JackDesBwa/Genfreq/board/schematics.pdf

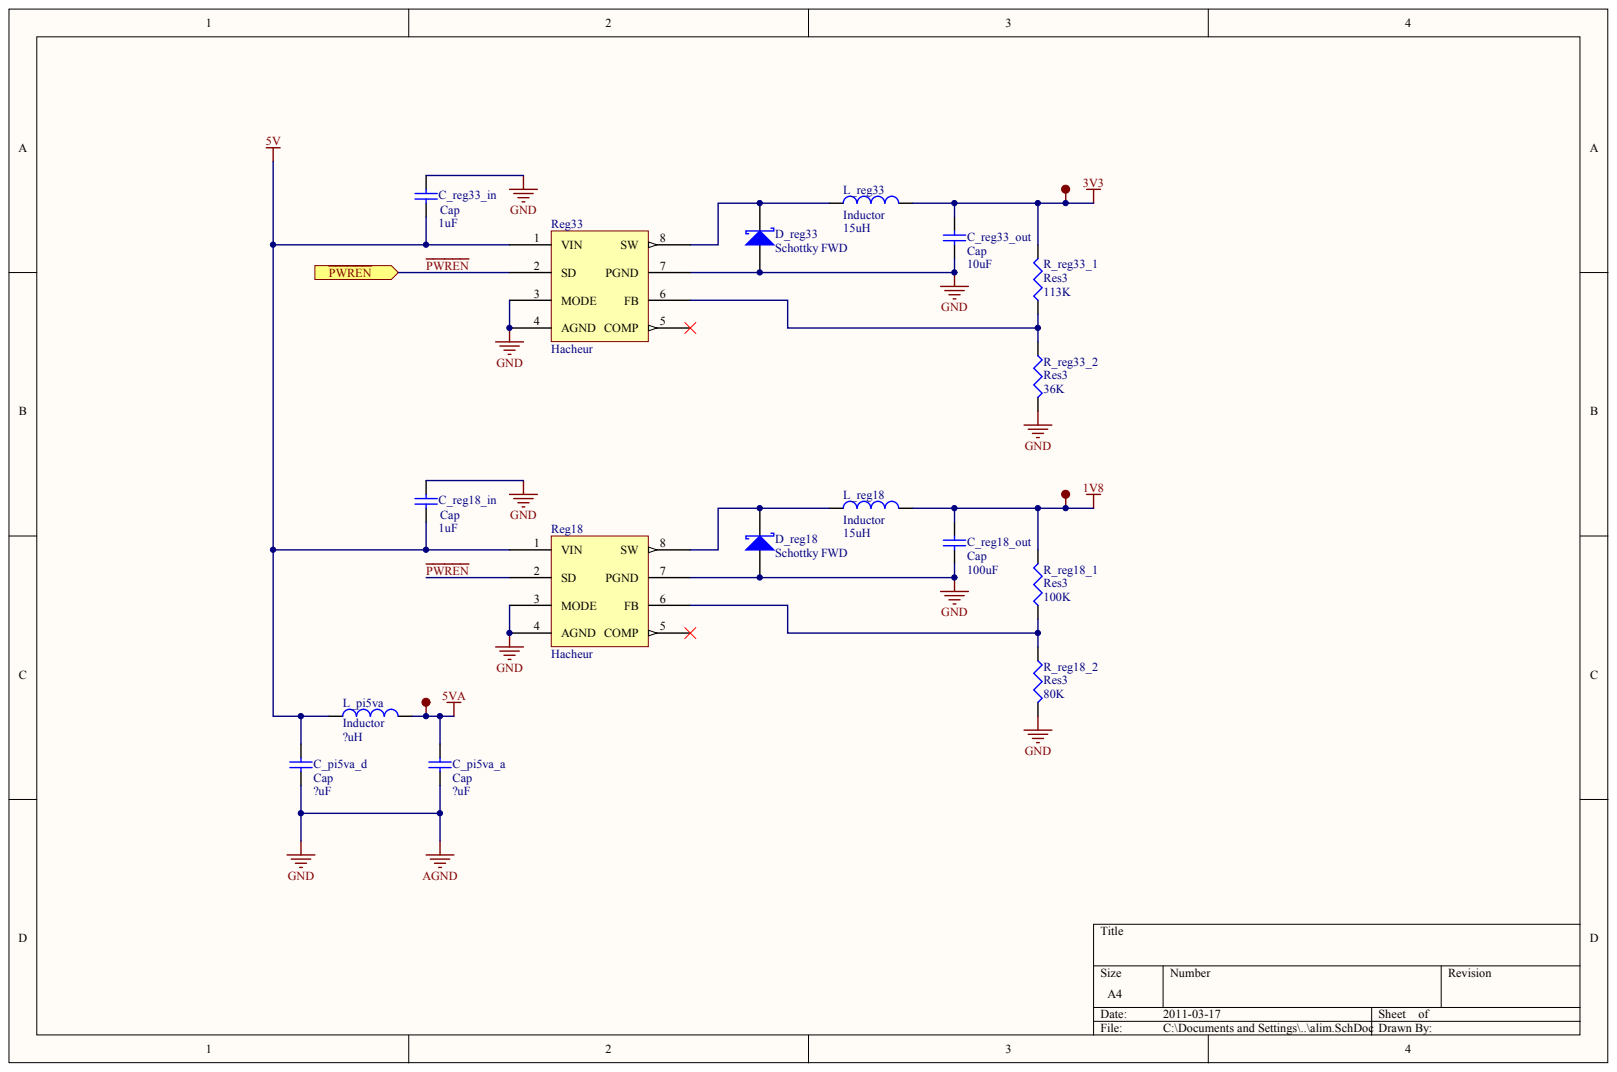
[picture p1: page 1]

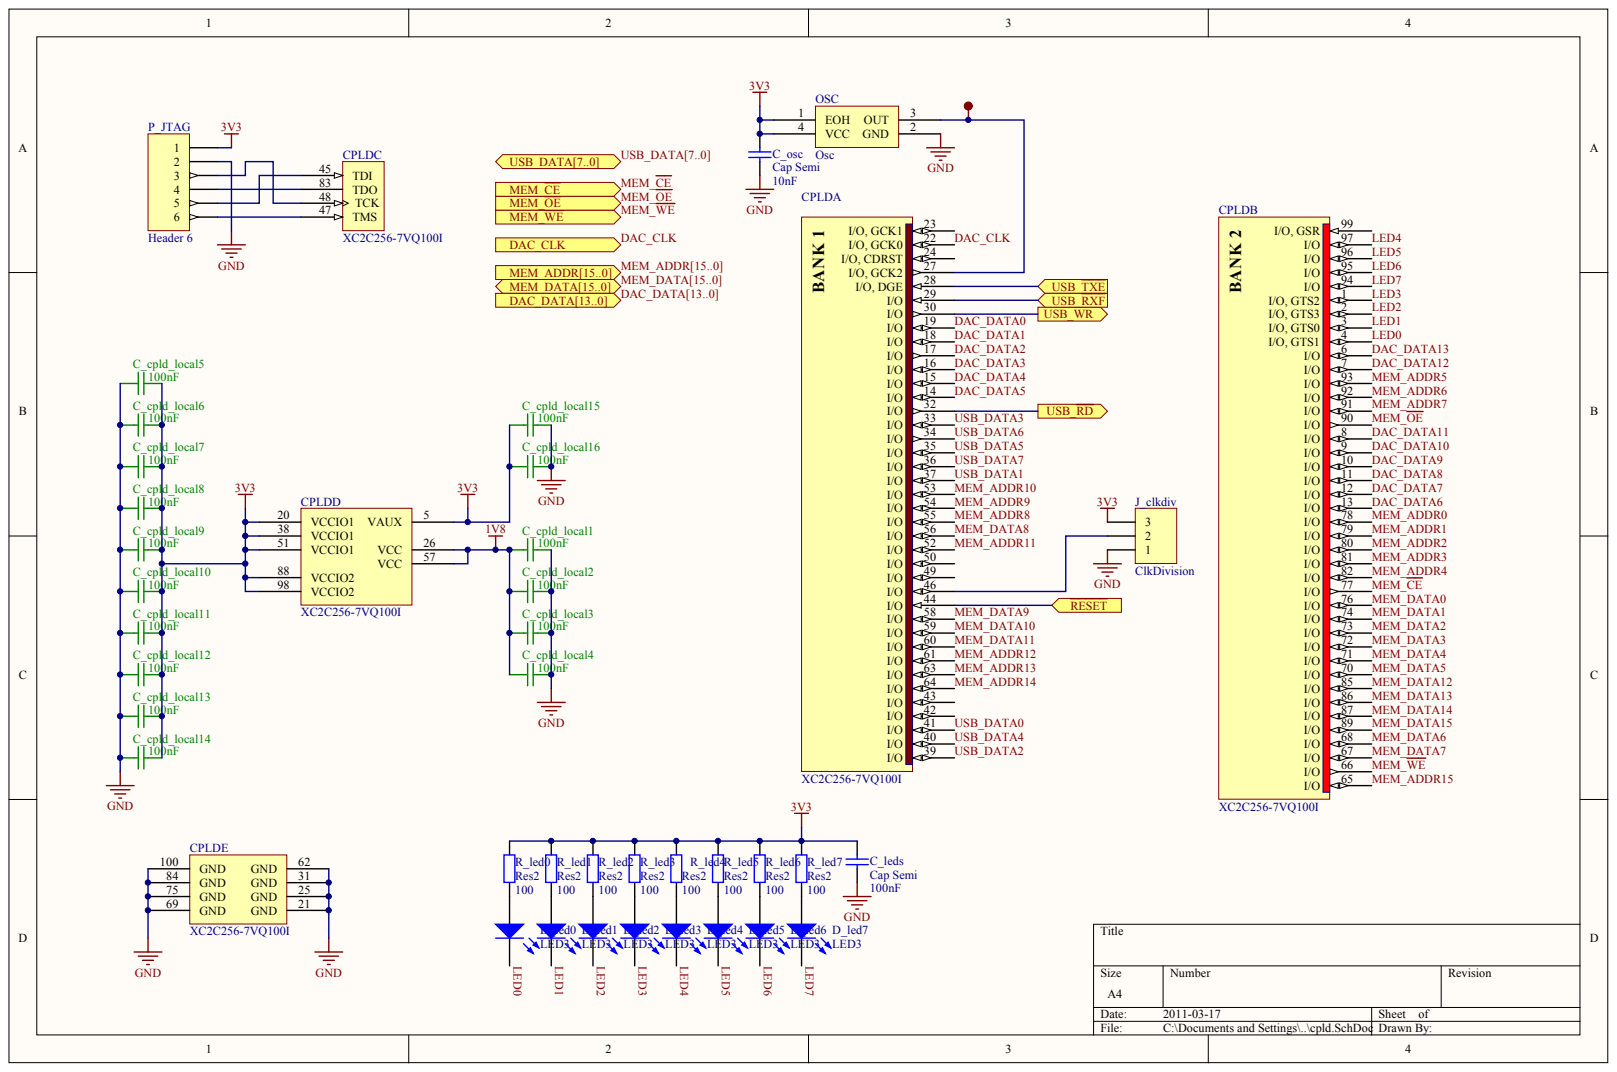
[picture p2: page 2]

TDO 83
TCK 48
TMS 47

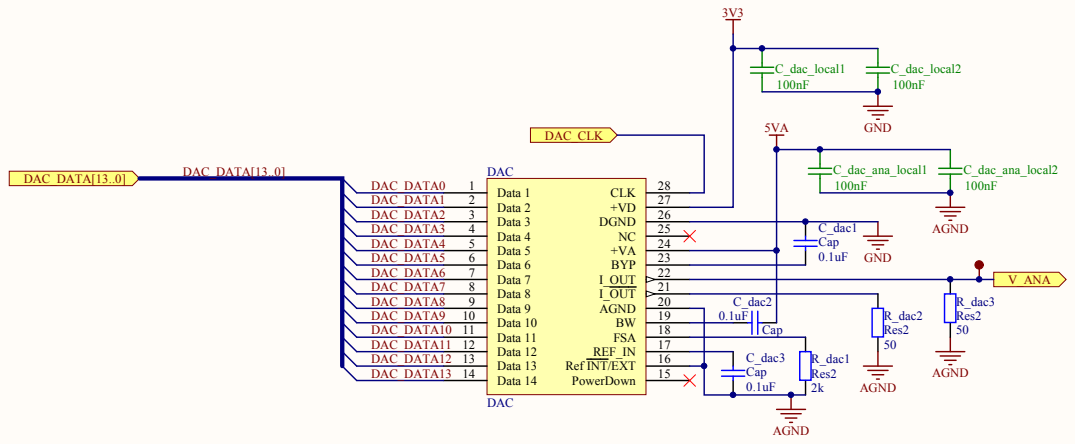
[picture p3: page 3]

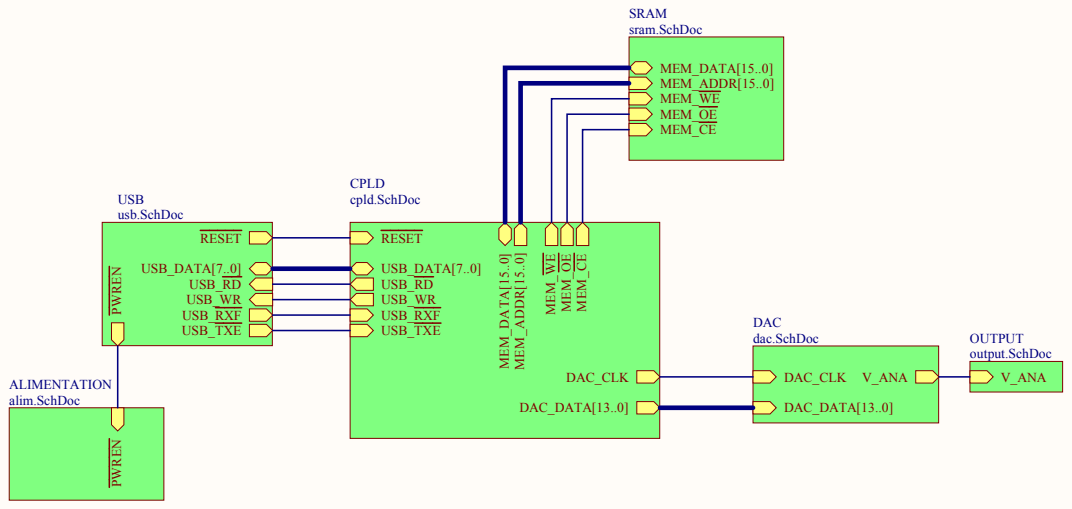
[picture p4: page 4]

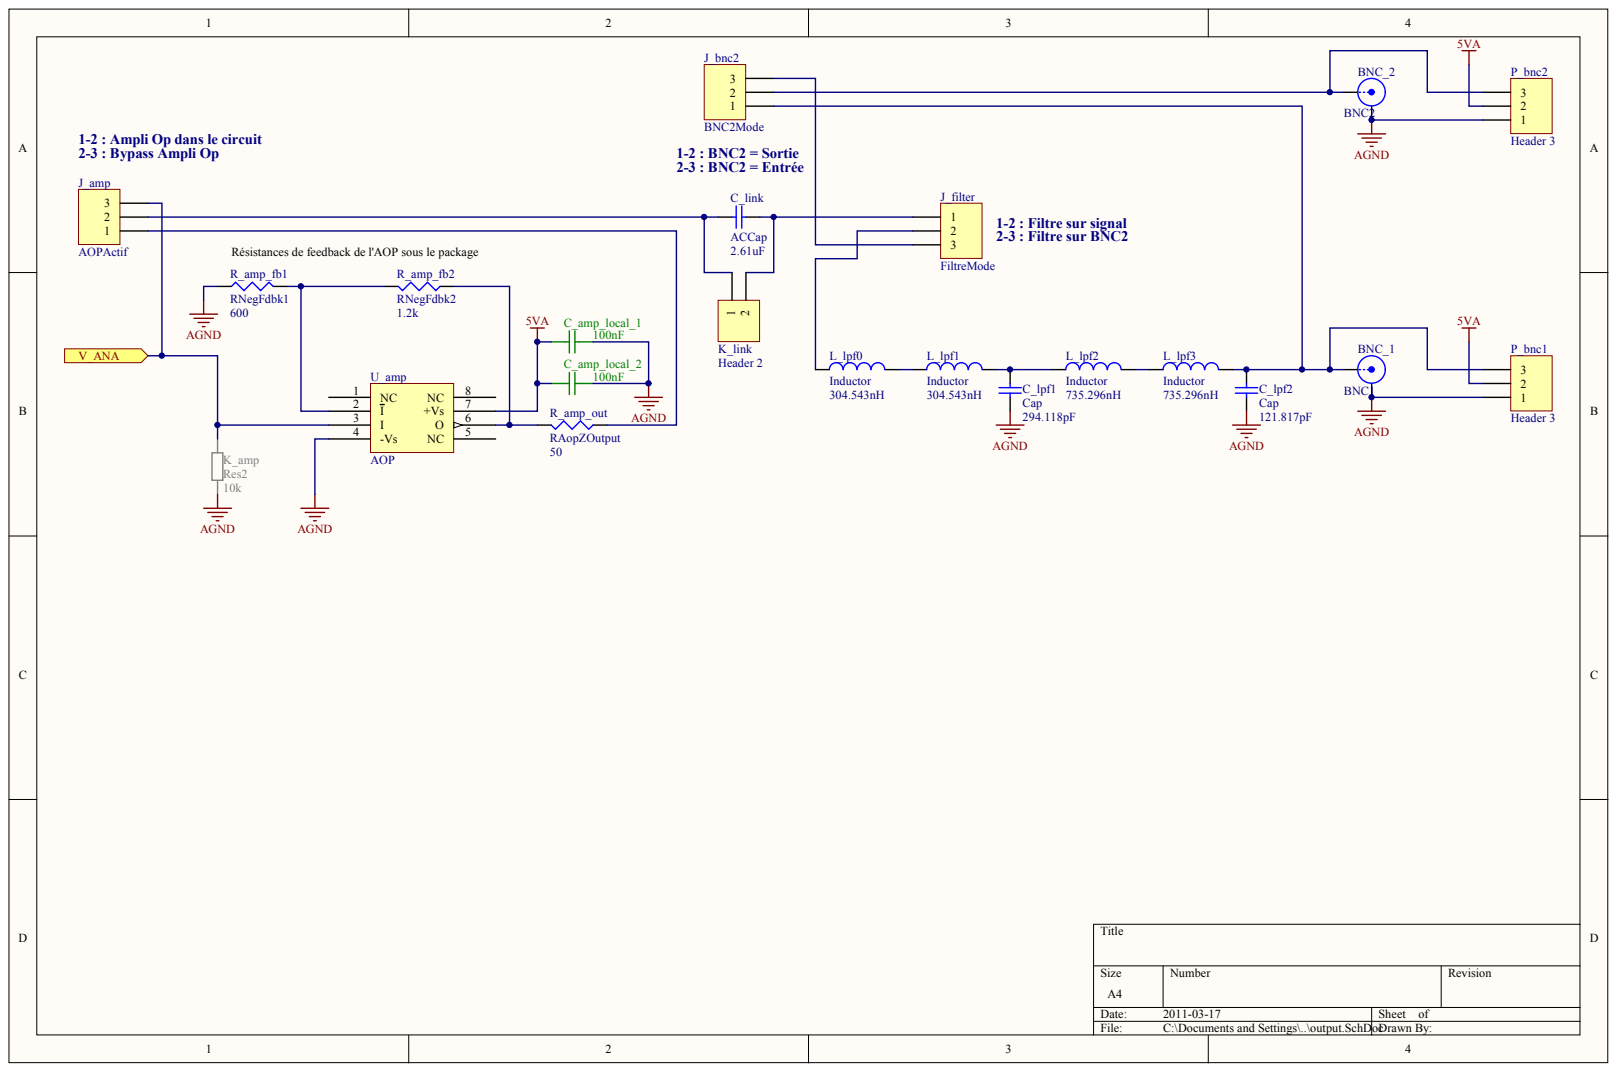
[picture p5: page 5]

1-2 : Ampli Op dans le circuit

Résistances de feedback de l'AOP sous le package

L_lpf0

BNC_1

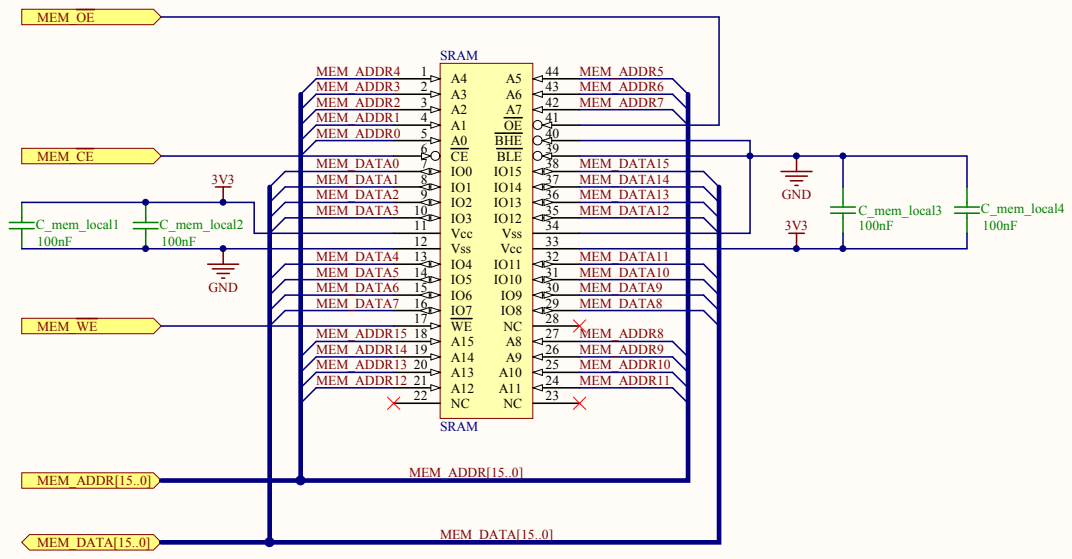
[picture p6: page 6]

MEM_ADDR2 MEM_ADDR1 | BLE A2 3 A1 4 | 39 BHE 40 OE 41 A7 42 A6 43 A5 44 A4 1 MEM_ADDR7

MEM_ADDR0 | A0 5 CE 6 IO12

3V3 | MEM_DATA0 MEM_DATA1 | IO0 7 IO1 8 | 35 IO13 36 IO14 37 IO15 38 | MEM_DATA15 MEM_DATA14

MEM_DATA2 | IO2 9 Vcc IO8 NC A11 | 33 Vss 34 | MEM_DATA13 MEM_DATA12

C_mem_local2 | | MEM_DATA3 | | IO3 10 Vcc 11

100nF | | 100nF | | | Vss 12

GND | | MEM_DATA4 MEM_DATA5 MEM_DATA6 | IO4 13 IO5 14 IO6 15 IO7 16 WE 17 | 29 IO9 30 IO10 31 IO11 32 28

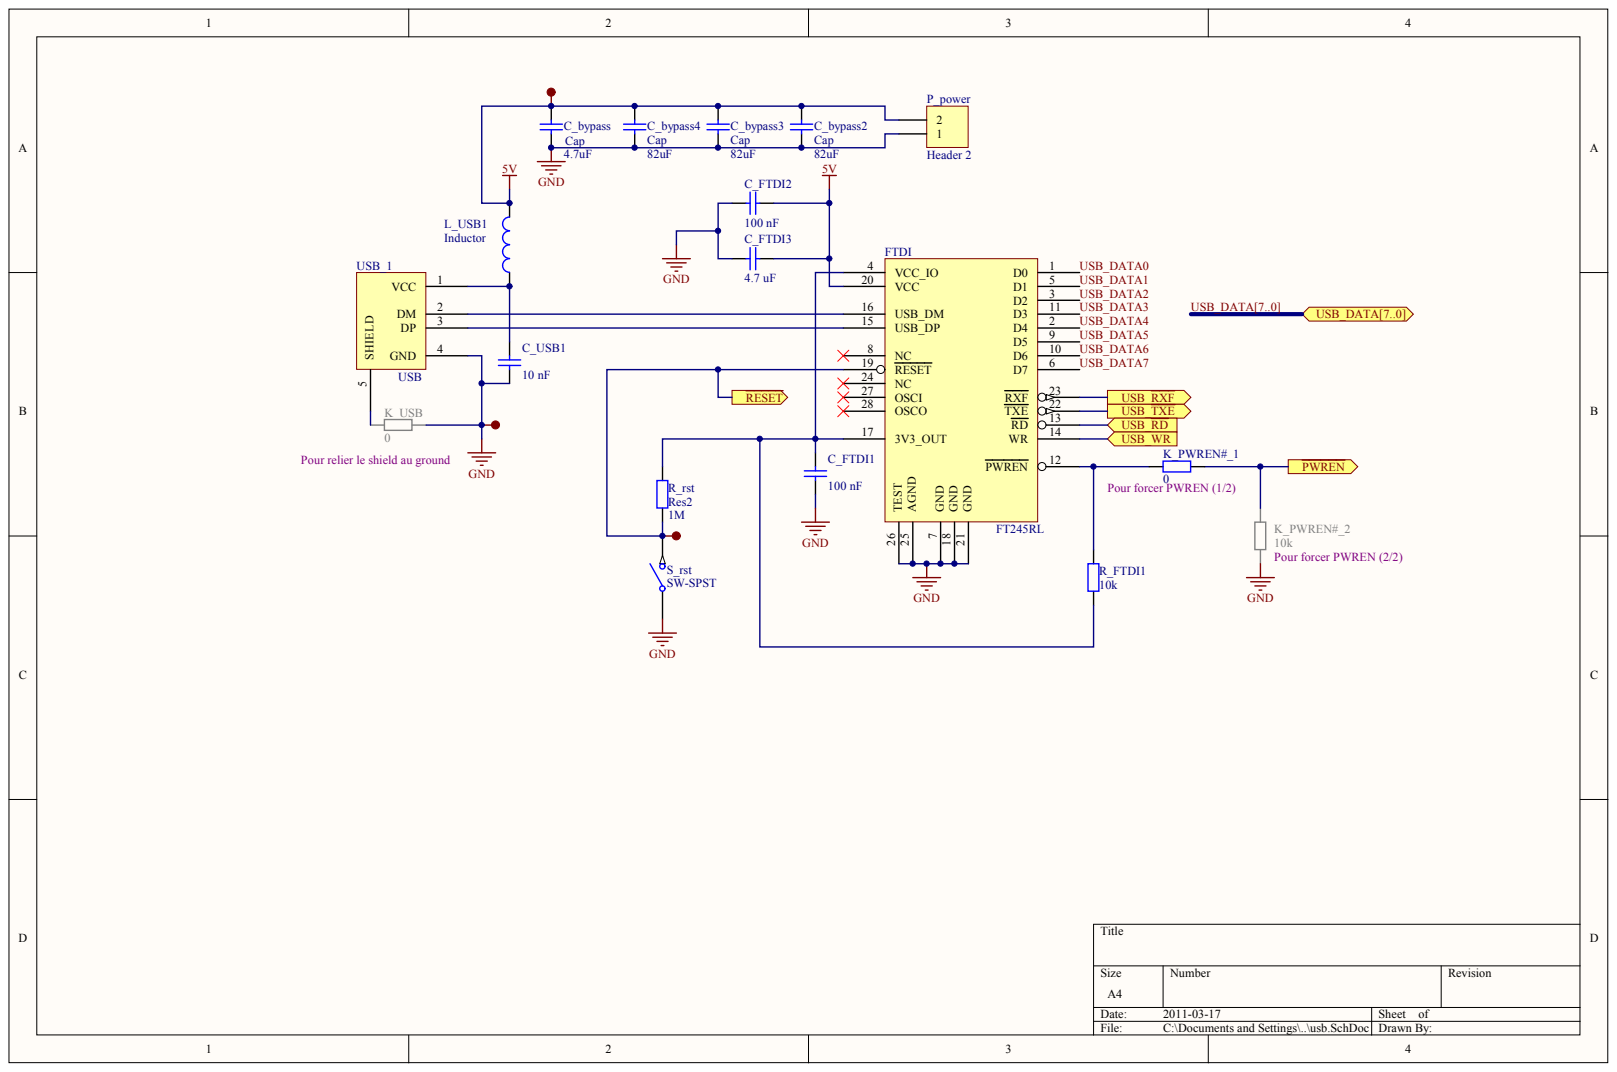
[picture p7: page 7]

Pour relier le shield au ground

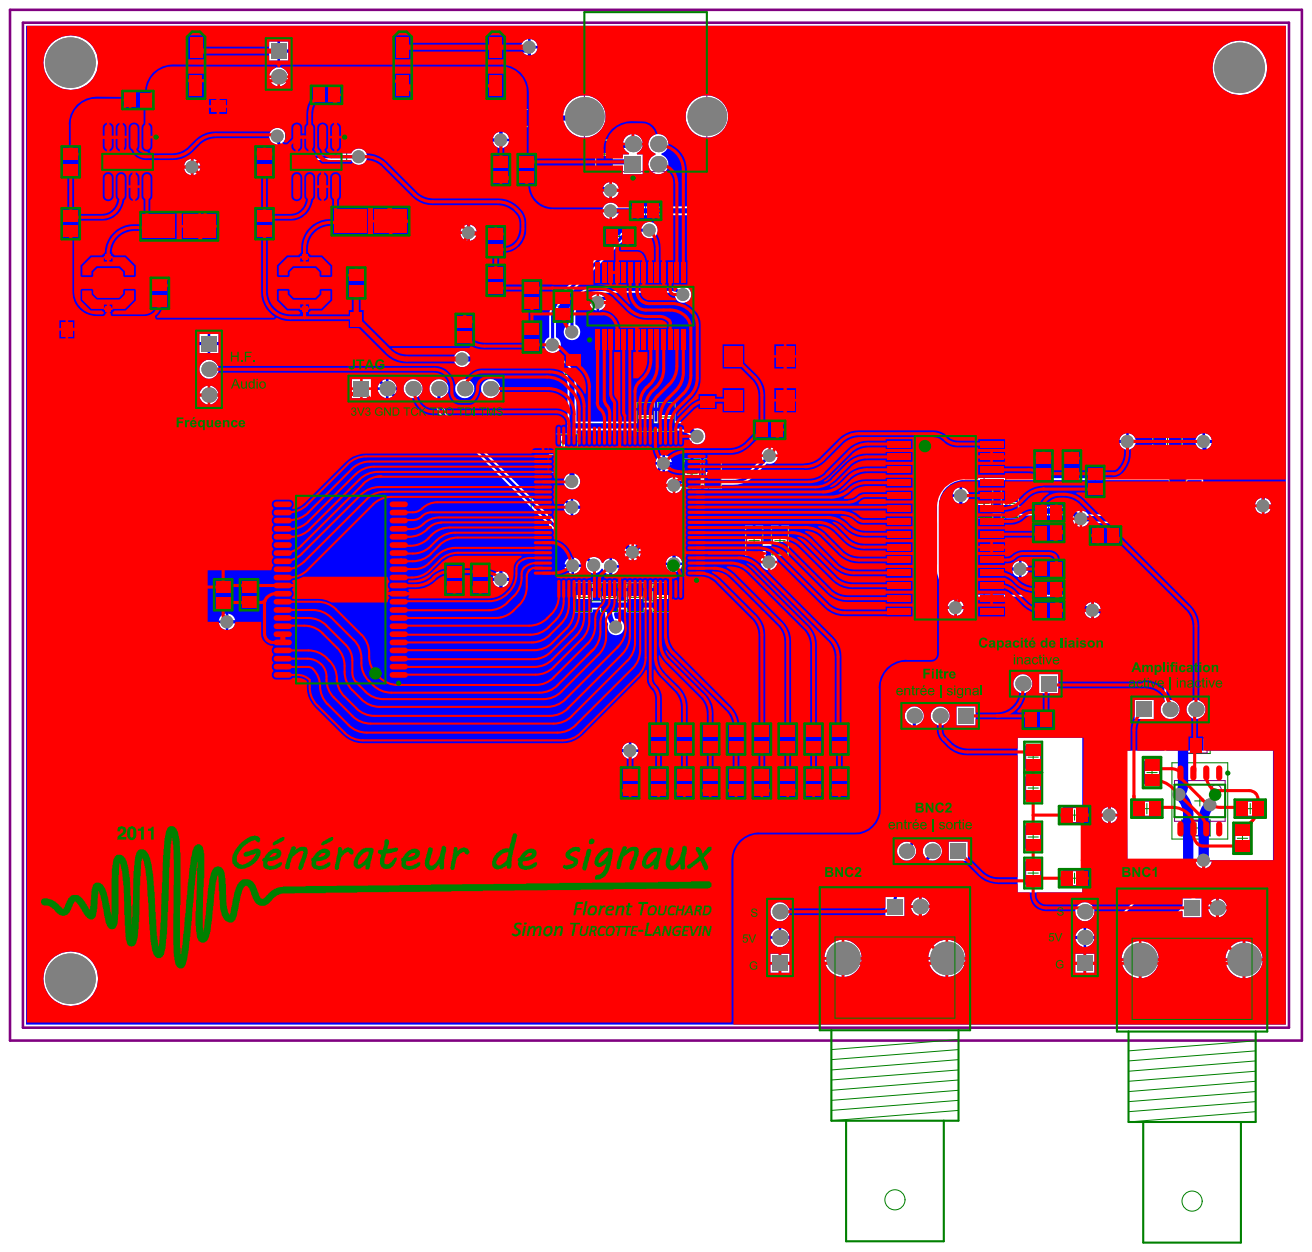
[picture p8: page 8]
