JackDesBwa/Genfreq/(list of files, drawings)

Other design files:
board/altium/alim.SchDoc
board/altium/board.PcbDoc
board/altium/cpld.SchDoc
board/altium/dac.SchDoc
board/altium/genfreq.PrjPCB
board/altium/global.SchDoc
board/altium/ourlibs.SchLib
board/altium/ourprints.PcbLib
board/altium/output.SchDoc
board/altium/sram.SchDoc
board/altium/usb.SchDoc
