JackDesBwa/Genfreq/(commit log)

2015-03-04 add Altium project
    [alim.SchDoc, board.PcbDoc, dac.SchDoc, genfreq.PrjPCB, global.SchDoc, ourlibs.SchLib, ourprints.PcbLib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]
2015-03-04 add gerbers files
    [board.GBL, board.GBO, board.GBS, board.GM1, board.GTL, board.GTO, board.GTS]
2015-03-04 add PDF-exported schematics
2015-03-27 vhdl: fix missing whitespace in numeric constant
    [uut_sram_module.vhd]
